UPetersen/LibreMonitor/GlucoseVsRawForDifferentTemperatures.png

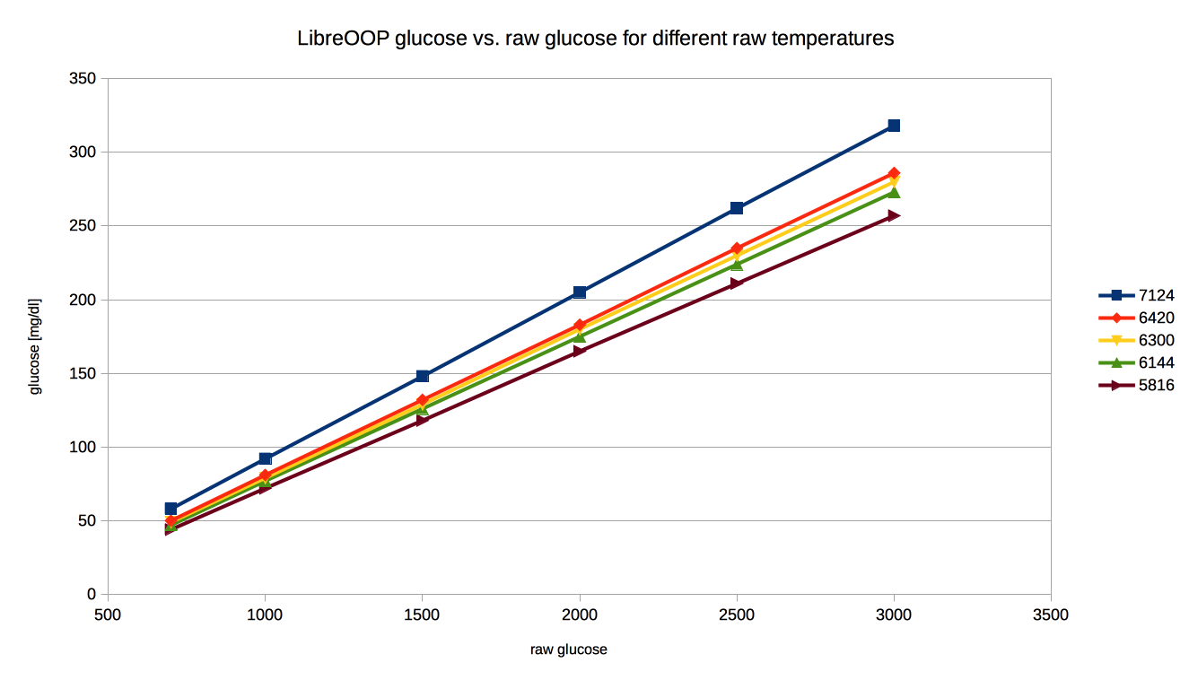
GlucoseVsRawForDifferentTemperatures.png
