UPetersen/LibreMonitor/GlucoseVsRawTemperatureForDifferentRawGlucoses.png

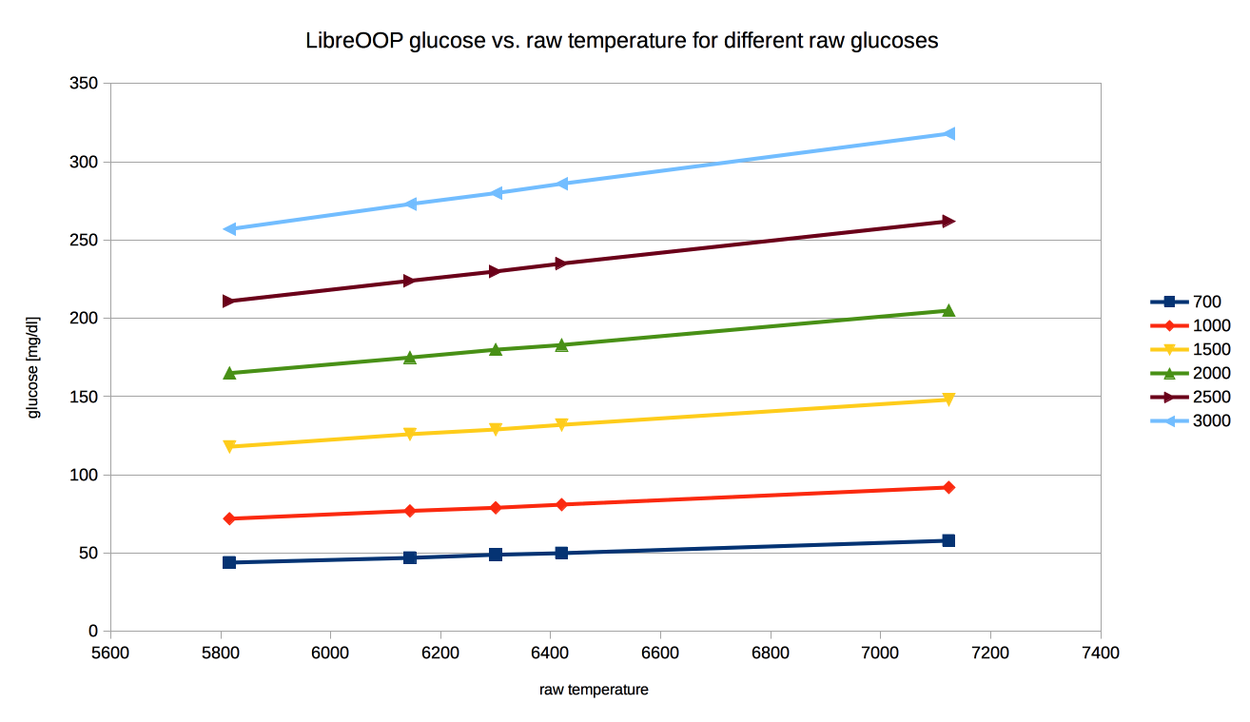
GlucoseVsRawTemperatureForDifferentRawGlucoses.png
