UPetersen/LibreMonitor/GlucoseVsRawTemperatureForRawGlucose700.png

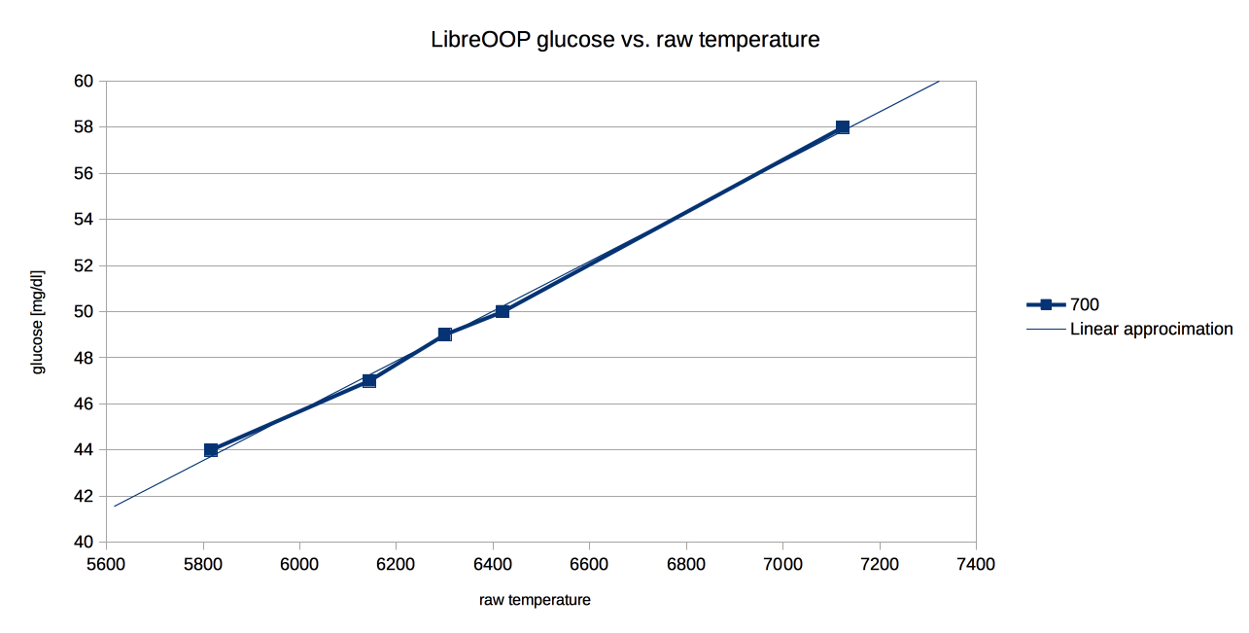
GlucoseVsRawTemperatureForRawGlucose700.png
