UPetersen/LibreMonitor/LinearResponseToRawGlucose.png

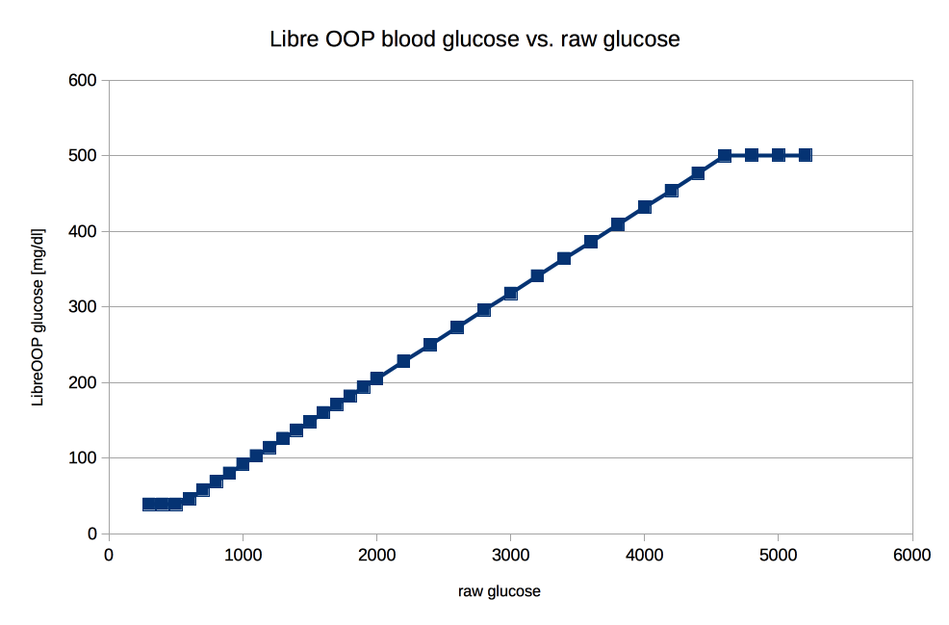
LinearResponseToRawGlucose.png
