UPetersen/LibreMonitor/SlopeAndOffsetVsRawTemperature.png

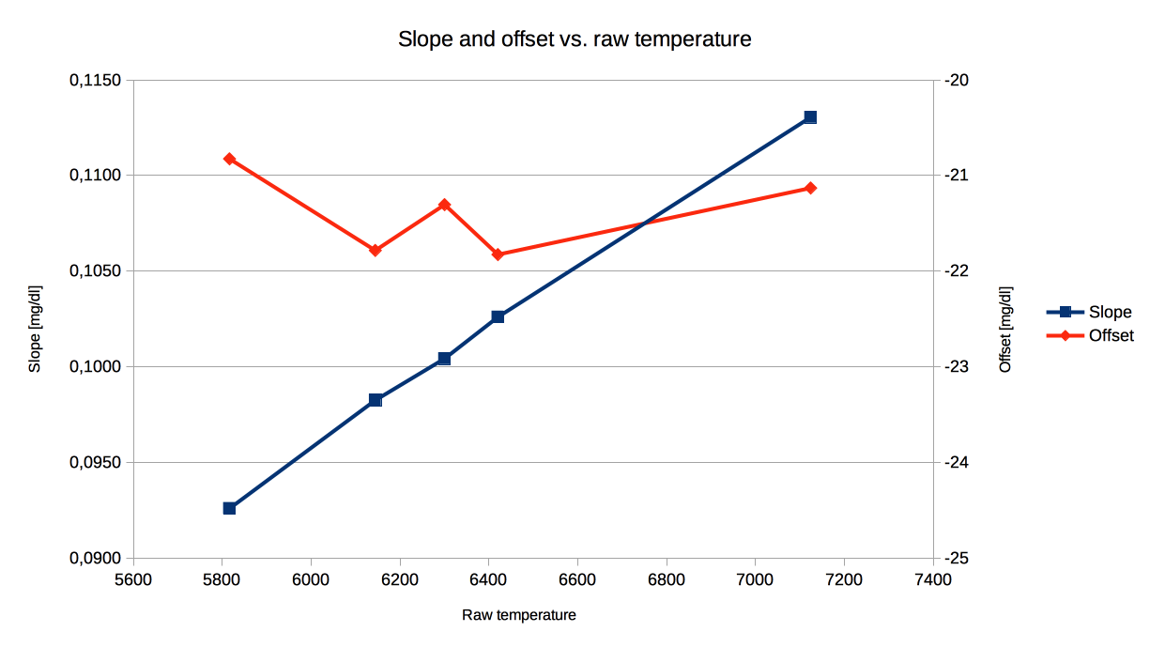
SlopeAndOffsetVsRawTemperature.png
