UPetersen/LibreMonitor/(threads)

Thread 2 (2016-11-23):

Sketchs from Arduino

hferreira, 2016-11-23:
Hello,

I built a limiter myself.

Some questions:
1. What are the differences between Simblee and RFDuino ?
2. The sketch from Limmiter will work on RFDuino without modifications, right ?

Regards,
Hugo.

UPetersen, 2016-11-23:
Hi Hugo,

My first LibreMonitor was built with an RFDuino and worked well. I then switched to a Simblee because it is smaller and also allows for FOTA (which I have not really used yet). So much for the differences (for more on this see the respective websites)

If you build a LibreMonitor with an RFDuino instead of a Simblee, you have to change some code in the LibreMonitor.ino file and in libUBP.cpp in LibreMonitorArduinoLibrary.zip. Basically you have to substitute „Simblee“ by „RFDuino“. I just looked quickly through the code. It should be the following two changes:

1. Use the appropriate includes for RFDuino instead of those fore Simblee
2. Change the Simblee commands to the respective RFDuino commands, e.g. change SimbleeBLE.advertisementData = "data" to RFDuinoBLE.advertisementData = "data"; etc.

Please refer to the manuals of [Simblee](https://www.simblee.com/Simblee%20Functions%20Reference%20V1.0.pdf) and [RFDuino](http://www.rfduino.com/wp-content/uploads/2014/03/rfduino.ble_.programming.reference.pdf) for details and possible differences of these commands.

If you do these code changes using #ifdefs in the code and submit a pull request I could check them in and it would be of help for others who want to build a LibreMonitor with an RFDuino, too. One could switch quite easily between Simblee or RFDuino by changing some #define commands and the includes in the info files.

Regards
Uwe

hferreira, 2016-11-23:
Ho, I thought that Simblee was a superset of RFDuino and larger than the original one, using the same chip on his core but I check and see that RFDuino is 15mmx15mm and Simblee is 7mmx10mm.

hferreira, 2016-11-23:
Hi Uwe,

Ho, I thought that Simblee was a superset of RFDuino and because of that was larger than the original one, using the same chip on his core but I checked and I saw that RFDuino is 15mmx15mm and Simblee is 7mmx10mm.
It's a superset yes but smaller, right ?
So, on this case it's more wise to use Simblee instead of the original RFDuino.

From the RFDuino website (so, the same should be applied for Simblee), the Arduino sketch should work of of the box for RFDuino, but you have some dependencies from Simblee, why ?
The original Limitter.ino can't work ?

Regards,
Hugo.

UPetersen, 2016-11-24:
Hi Hugo,

I am not sure, what you are aiming at and what you mean with "original Limitter.ino". Is it the Limitter.ino of the [LimiTTer Project](https://github.com/JoernL/LimiTTer) by JoernL? If so, the answer is no. The Limitter.ino will not work with LibreMonitor because LimiTTer and LibreMonitor transfer different sets of data between the reader device and the respective smart phone application.

If you want to use your device with LibreMonitor follow my suggestions above and you can display the data with the LibreMonitor iOS application.

If you want to build a LimiTTer and display the data with the corresponding application you have to make adaptions to its LimiTTer.ino to make it work with an RFDuino, but I cannot tell you what exactly has to be changed. You could try and ask this question on the respective [Gitter blog](https://gitter.im/JoernL/LimiTTer) and maybe get some help.

Regards,
Uwe

hferreira, 2016-11-24:
Hi Uwe,

I already have my own fork of the Limitter.ino working with my own Android App.
I thought that my ino sketch could work out of the box with RFDuino, because RFDuino is a kind of clone of Arduino + Bluetooth module but for what you are saying it's not just that easy, so I will have  review the code or start over again from your ino sketch.

The ideia behind using RFDuino (or Simblee) is to reduce the size and connections of the hardware.
By luck, seems that most of RFDuino/Simblee pins can be soldier next to BM019.

Regards,
Hugo.

UPetersen, 2016-11-25:
Hi Hugo,

wish you good luck.

Regards
Uwe

hferreira, 2016-11-25:
Thanks.

Closed 2016-11-25.

Thread 3 (2016-12-14):

Prepare the RFDuino/Simblee board

hferreira, 2016-12-14:
Hello,

After several weeks of delaying, I finally got my RFDuino  (similar to yours).
How did you safely remove the plastic from the pins to attach on the NFC board ?

Regards,
Hugo.

hferreira, 2016-12-14:
Nervermind. It was easy.

UPetersen, 2016-12-14:
Hi Hugo,
I have been working on a RFduino version, too. I just committed my current code for your ease. It is still work in progress and not yet tested, but probably a better starting point than the original code in this repository. (I seem to have a loose contact somewhere. So I could not receive valid data from the BM019, yet, but data transfer to the iOS app works.). You'll find some instructions in the comment section of the ino-File.
Regards
Uwe

hferreira, 2016-12-14:
Thank you very much.
It's a good starting point.

hferreira, 2017-01-09:
Hello,

I was out for a while and now I came back and return to this project.
Starting with your INO file and after compile and upload I got on my Arduino IDE debug window informing that the setup was successful (also my Android App can be notified about the connection) and it fails when to retried data from BM019 but this is probably the issue that you mention.

Regards,
Hugo.

basma37, 2019-05-03:
I have a compile error when trying to upload a code on rfduino

basma37, 2019-05-03:
Error is cannot run program(runtime.tools.arm-none-eabi-gcc.path)...

UPetersen, 2019-05-04:
This does not look like a LibreMonitor specific error to me, but rather like something general regarding rfduino. Have you managed to run any code on your rfduino so far?

Closed 2018-04-25.

Thread 4 (2016-12-18):

Light always fixed

hferreira, 2016-12-18:
Hello,

I already connected all wires on a breadboard (RFDuino + NFC-BM019).
I saw a lot of compile issues on your RFDuino ino version so I downloaded the original one and replaced all Simblee references to RFDuino. Compiled and uploaded to the hardware.

My Android App (that previous worked with Limitter, so the main difference should be the UUID address) is never notified but I also noticed that the NFC chip have the light always fixed.
On my previous version (based on Limitter), the light is off when is sleep mode and turn on when is reading.

PS: I already checked the wire connections over and over again.

Regards,
Hugo.

UPetersen, 2016-12-18:
Hi Hugo,

### Wiring

With the LibreMonitor wiring the red light on the BM019 will shine permanently. That is the intended setup using the on-board voltage regulator of the BM019. It is directly connected to the lipo and the 3.3 V output of the regulator serves as input to the RFduino.

### Ino-File and LimiTTer application

Using the LibreMonitor.ino file you will NOT be able to communicate with an app that expects data from a LimiTTer, as already noted in [issue2](https://github.com/UPetersen/LibreMonitor/issues/2). LibreMonitor and LimiTTer use similar hardware but are totally different on the software side since they use

- a different protocol to transfer data and
- a different set of data that is transferred between device and smartphone application.

Thus, the LibreMonitor.ino only works with the LibreMonitor iOS application. If you want to use a different application you have to either change the ino file accordingly to provide LimiTTer-like data or adjust your application to work with the LibreMonitor data set.

I am still not sure, If I correctly understand what your intention is. Do you want to make your Android application behave as the LibreMonitor iOS application and use the same protocol and data set? Or do you want to leave your app as it is and make the RFduino setup behave as a LimiTTer?

Regards
Uwe

hferreira, 2016-12-19:
Thank you for the explanation about the wiring.
OK, I see. It's always shinning (in opposite to Limitter) consuming a little more energy but not that much because only periodically BM019 is activated to read, so it's in a hibernate mode, correct ?

"Using the LibreMonitor.ino file you will NOT be able to communicate with an app that expects data from a LimiTTer"
Yes, I know. I have my own App and not xDrip. The base BT connection should be the same. Only the UUUID can be different and the chosen protocol that can be easily changed on INO or on my App.

I can now receive notifications on my App from the device trying to connect but still not fire the characteristics. I will investigate more.

Thank you very much for your time.

Regards,
Hugo.

UPetersen, 2016-12-19:
Correct, BM019 is periodically set to hibernate mode. After that the Simblee/RFduino is set to ultra low power mode (Simblee_ULPDelay(SLEEP_DURATION) /  RFduino_ULPDelay(SLEEP_DURATION) with SLEEP_DURATION set to two minutes). After the two minutes the Simblee/RFduino wakes up, wakes up the BM019, both do their job and then go to sleep again...

Note, using the Simlcee/RFDuino_ULPDelay(...)-command the Simblee/RFduino remains connected to the Smartphone application, but energy consumption is low. I like this mode since it can be conveniently used as a permanent indication for a working connection.

##### Data Transfer

I use [this ](https://github.com/cconway/RFduinoUBP) code to have a simple to use protocol. You can give it a c-struct with content longer than 20 bytes. The data is encapsulated using [SLIP](https://de.wikipedia.org/wiki/Serial_Line_Internet_Protocol) and a crc8 is appended to ensure data integrity. The packet is then transferred to the iOS application. There the crc8 is checked and if it is okay the packet is decoded back to the original struct. I made some changes to the [original code](https://github.com/cconway/RFduinoUBP) to make it work with the 344 bytes, so you may want to use the code from the LibreMonitor repository.

The c-structs are defined in [data_types.h](https://github.com/UPetersen/LibreMonitor/blob/master/LibreMonitor/Bluetooth/data_types.h). The main Freestyle Libre data that is transferred are the 344 bytes in "allBytes" of the struct "AllBytesDataType" that correspond to Blocks 0x00 to 0x2A when you read a sensor with [tagInfo](https://play.google.com/store/apps/details?id=com.nxp.taginfolite&hl=de) or some other tag reader. You can follow the code in [SensorData.swift](https://github.com/UPetersen/LibreMonitor/blob/master/LibreMonitor/Model/SensorData.swift) and corresponding files on how to get desired information such as history and trend raw glucose data.

##### Bluetooth

The main part of the bluetooth code on the application side is in [SimbleeManager.swift](https://github.com/UPetersen/LibreMonitor/blob/master/LibreMonitor/Bluetooth/SimbleeManager.swift). In there you find how I handle the UUIDs, services and characteristics. When a data packet is received it is then handled in [this](https://github.com/UPetersen/LibreMonitor/blob/master/LibreMonitor/ViewControllers/BloodSugarTableViewController.swift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) part of BloodSugarTableViewController.swift. This is where the c-structs are received as "payloads" and the data is extracted.

Hope this provides some help for your own application. It took me quite some time to understand the bluetooth stuff and build this application. Wish you good luck.

Of course you can use any other more simple protocol for data transfer.

Regards,
Uwe

Thread 5 (2016-12-21):

Parts needed for a LibreMonitor are - broken battery link

clvsjr9, 2016-12-21:
The lipo link indicated is broken

UPetersen, 2016-12-21:
I still use a 100 mAh lipo that I took out of a little model helicopter. It lasts a full day from early morning to late evening with the transfer interval set to two minutes. To my understanding any lipo with 110 mAh or more should do. If you want a longer time you could go higher, e.g. 200 mAh. A higher discharge rate is probably better and enables using a faster charger. I corrected the link in the readme for a lipo that should be appropriate.

Closed 2016-12-21.

Thread 6 (2016-12-21):

Switch lipo charger example

clvsjr9, 2016-12-21:
Could you indicate a switch lipo charger URL to appreciate?

UPetersen, 2016-12-21:
I only have experience with the first of the two Adafruit lipo chargers that are mentioned in the readme and the "SparkFun LiPo Charger Basic", which worked fine, too. I have no experience with any other lipo and thus cannot recommend any other.

clvsjr9, 2016-12-21:
The readme file presents the follow text:

Switch (optional but helpfull if you mount a lipo charger).

Could you point to me any product to this item? (I'd like to use one)

UPetersen, 2016-12-22:
A switch is helpful to disconnect the BM019 and Simblee/RFDuino from power, if the device needs a reset. LibxMike used a setup with a switch, as you can see in the picture in the readme. I haven't used a switch by myself, yet, and that is why I did not provide a link and cannot really recommend one from own experience. I always disconnect and reconnect the JST plug of the lipo if a reset is needed. I made a quick search and think the following [switch](http://www.exp-tech.de/mini-slide-switch-3-pin-spdt-0-3a-3-pack) should be okay and serve your needs.

clvsjr9, 2016-12-24:
Very thanks!

Closed 2016-12-24.

Thread 7 (2017-01-10):

Thank you

hferreira, 2017-01-10:
I created this issue only to thank you UPeterson.

My current INO file it's very different but finally working now !
Your layout helped me go to there.
I had to remap the original pins: http://www.rfdigital.com/wp-content/uploads/2014/03/rfduino.ble_.programming.reference.pdf and probably it's one difference comparing to Simblee.
I wanted the pins on the same configuration as yours because fits perfectly on BM019.

Best regards,
Hugo.

UPetersen, 2017-01-10:
Hi Hugo,

great to hear, that you got your device working. Congrats.

Regarding the remapping I actually put some information in the [LibreMonitor.ino](https://github.com/UPetersen/LibreMonitor/blob/master/LibreMonitor.ino#L26) as guidance on how to modify the variant.h file and a note on this in the [README.md](https://github.com/UPetersen/LibreMonitor/blob/master/README.md). But thanks to your remarks I will make this more prominent in the future.

Just out of curiosity: What kind of smart phone app do you use? Is it based on LibreMonitor or did you develop it yourself or?

Best regards,
Uwe

hferreira, 2017-01-10:
Hi Uwe,

Thank you.

Yes, the remapping was missing for me and it's a key feature for this project because allows to connect to NFC directly and reduce wires.

My own App: https://play.google.com/store/apps/details?id=pt.solidsoft.appforlibre
This App allows to read directly from NFC (like others) and I changed enough to also read from BLE reusing the same Widget and chart.

Best regards,
Hugo.

Thread 8 (2017-01-16):

Battery test

hferreira, 2017-01-16:
Hello,

I made 2 tests with a full charged batteries:
- LiPo 3.7v 240mAh - After 24h with 3 m sync period consumed only 35%.
- LiPo 3.7v 120mAh - After 18h with 5 m sync period consumed 90% and the system sttoped to communicate.

Do you think this is a normal behaviour ?

Regards,
Hugo.-

UPetersen, 2017-01-16:
Hi Hugo,

I have been using a 150 mAh lipo for a long time. I put the libreMonitor on ever morning and take it off when I go to bed (because I don't want to lie on it and possibly brake it, since I still don't use a case) and then I charge it over night. With a reading every two minutes even on long days with up to 18 or 20 hours it still worked when I took it of. And this even though the Simblee keeps a permanent bluetooth connection to the iPhone between the readings (with "Simblee_ULPDelay" command).

I put your and my values in the following table. Unfortunately I don't have a means to measure the remaining capacity for my lipo so I just assumed 100 percent.

|        | Hugo 1 (RFduino)| Hugo 2 (RFduino) | Uwe (Simblee) |
| :--- | :---:  |     :---:      | :---: |
|lipo energy [mAh] | 240 | 120 | 150 |
|used energy [%] | 35 | 90 | 100 |
|used energy [mAh] | 84 | 108 | 150 |
|usage time [h] | 24 | 18 | 18 |
|delay between readings (min) | 3 | 5 | 2 |
|reading frequency [1/h] | 20 | 12 | 30 |
|number of readings in usage time | 480 | 216 | 540 |
|energy consumption per reading [mAh] | 0,175 | 0,5 | 0,28 |

So your large lipo performs very well in comparison to mine but your smaller lipo could do better. Overall it looks reasonable to me. Since I don't know what changes you possibly made: Please note that this comparison is only valid on the assumption that you read and transfer the same amount of data.

Regards,

Uwe

hferreira, 2017-01-16:
Hi Uwe,

Thank you very much for your comparison table.
I will also test for 2 minutes.
Do you find that there is any side effect with 1 minute besides the battery faster consume.

Yes I used always the same sample data to avoid mistaken results.
I agree that my large lipo performs very well (more that what was expected), however my smaller lipo is not enough (I wanted 24h / one day charge) for the same 3 minutes (at most).
Shouldn't the smaller lipo performance as 50% comparing to the bigger one ?
I mean, for he same 24h (3 minutes delay), consume 70% energy ?

Regards,
Hugo.

UPetersen, 2017-01-17:
Hi Hugo,

I never tried a one minute interval. I just don't think it is necessary. I like the two minutes pretty much. Three minutes seems reasonable, too, but five minutes is just to long for me.

I am not sure if the one minute interval will have side effects.

Regarding side effects: Rarely, but it sometimes happens that I don't get a response from LibreMonitor any more and the Freestyle Libre Reader also refuses to provide values. Usually, after a while everything works fine again. And usually I take the LibreMonitor of when this happens. I do not know why this happens and I don't know if this is caused by LibreMonitor at all. But for sure I know that I had observed this with sensors before having started to use LibreMonitor, too. Same with sensors that completely failed. Just got two such cases recently with sensors that were very close to their expiry date. But also did have this in the early days without LibreMonitor.

To sum up: If you are keen on a one minute interval you have to try yourself. I personally would not expect problems, but who knows. And yes, I'd be interested in the results.

Lipo: Yes, I would have expected the small lipo to perform more equally, too. Maybe it has a different discharge capability (if this is of influence) and it could also be just a bad lipo. I guess that to be really sure about lipo performance and requirements more systematic tests will be necessary.

Regard
Uwe

hferreira, 2017-01-18:
Hi Uwe,

"I never tried a one minute interval. I just don't think it is necessary. I like the two minutes pretty much. Three minutes seems reasonable, too, but five minutes is just to long for me."
I agree with you.

"I am not sure if the one minute interval will have side effects."
Stop working for example but I will use 2 or 3 minutes.

"Regarding side effects: Rarely, but it sometimes happens ... "
I'm doing tests and experience exactly the same behaviour (I see that I'm not alone here :))

"Lipo: Yes, I would have expected the small lipo to perform more equally, too. Maybe it has a different discharge capability (if this is of influence) and it could also be just a bad lipo. I guess that to be really sure about lipo performance and requirements more systematic tests will be necessary."
I have been reading about discharge capability and in theory yes, it can influence a little but I don't believe that much. I bet in got bad 120mAh Lipo and a very good 240mAh one.
I'm expecting to receive tomorrow a new 150mAh (with the same discharge capability as the 240mAh and let's see how performe this one).

Regards,
Hugo.

hferreira, 2017-01-19:
A new test with a new LiPo 150mAh.
After 24h with 3m interval it keep working with full charge (of course it's not possible and a read battery level issue) but working.

A will run a new 24h test with the same 150mAh LiPo but now with 2m interval.

kozyretti, 2017-12-28:
What about safety of LiPo using?
The device is fixed on the arm all the time. Is this not dangerous?
I mean a sudden ignition.

UPetersen, 2017-12-28:
I do use a regulated Lipo and I haven't had any bad experience so far. Neither have I heard of any bad experience from similar projects like [LimiTTer](https://github.com/JoernL/LimiTTer).

Thread 9 (2017-03-09):

A series of build errors

erikstr, 2017-03-09:
I am trying to build the iOS app straight out of the fresh downloaded sources, but getting a lot of errors. Here is a screenshot of them. What am I doing wrong?
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

UPetersen, 2017-03-09:
Hi Erik,

have you installed cocoapods? There are some third party libraries used, that require cocoapods. For installation [https://cocoapods.org](https://cocoapods.org).

erikstr, 2017-03-09:
No, I hadn't :( sorry that I didn't pay attention to this.
However, even with the Charts lib installed, I still get compile errors :((
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

erikstr, 2017-03-09:
Here are the full details:
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

UPetersen, 2017-03-09:
Mmmh, that leaves me scratching my head. I just downloaded the code from GitHub myself, ran "pod install" in the directory, opened the workspace file and compiled with simulator vor iPhone SE and it runs. I use Xcode 8.2.1.
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

UPetersen, 2017-03-09:
Have you tried to clean the build (Product and then "alt" - "Clean Build Folder". Sometimes that helps.

UPetersen, 2017-03-09:
Also worth a try (last answer): [swiftc failed with exit code 1](http://stackoverflow.com/questions/41203153/swiftc-failed-with-exit-code-1).

UPetersen, 2017-03-09:
Or this one: [ERROR swiftc failed with exit code 1](http://stackoverflow.com/questions/38496582/error-swiftc-failed-with-exit-code-1).

erikstr, 2017-03-09:
8.2.1 here as well. Yes, I clean every time. I suspect, that I am doing something wrong with the Charts lib. The instruction there says "Drag the Charts.xcodeproj to your project". However you can't drag just this file leaving the whole folder structure behind, so I download the zip, unpack it and include the lib from there to the target.

erikstr, 2017-03-09:
I'll switch to my MacBook now and start over from scratch ...

UPetersen, 2017-03-09:
I never dragged the charts lib. I installed it via cocoapods. Try this: Once you have cocoapods installed, just download the complete LibreMonitor-project again. Open a shell, change into the LibreMonitor directory and there type "pod install". Then open the workspace file with Xcode and compile.

erikstr, 2017-03-09:
Success!
It turns out that the downloaded charts lib I previously linked is for macOS only, no iOS. Now the app compiles and runs on the iPhone. The RFduino connects also fine but I am getting no readings :( What worries me even more is that no BM019 ID is shown as when there is no connection between the RFduino and the BM019 module. The ino sketch compiled and loaded fine. How could I investigate this problem now? I checked the wiring, looks good. But the BM019 LED is lighting red. Is this normal?

erikstr, 2017-03-09:
Here is a screenshot:
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

UPetersen, 2017-03-10:
This looks good. The right light on the BM019 is right. And you have a bluetooth connection to the RFduino. Now you should check, wether you get valid signals on the Arduino side, best by using the serial monitor. Set the

`#define DEBUG `

and you should see some hex values. To reduce your waiting times, you can reduce the sleep time for tests, e.g. by setting it to 20 s:

`const uint64_t SLEEP_DURATION = 20000;  // Duration of Simblee ultra low power mode in ms`

Another important thing is to have the SPI wiring correct. If you wired as depicted in the pictures, you have to change the RFduino pins in software. This is done in the variant.h file. In my case this file is located (dependent on the Simblee/RFduino version) in

/Users/[my user name]/Library/Arduino15/packages/Simblee/hardware/Simblee/1.0.0/variants/Simblee or
/Users/[my user name]/Library/Arduino15/packages/RFduino/hardware/RFduino/2.3.3/variants

In this file set the defines for the SPI pins as follows:

```
///         #define PIN_SPI_SS           (3u)
///         #define PIN_SPI_MOSI         (5u)
///         #define PIN_SPI_MISO         (4u)
///         #define PIN_SPI_SCK          (6u)
```

I also sent you a private note on gitter.

Thread 10 (2017-09-27):

Translation for raspberry

F5OEO, 2017-09-27:
Thx for your amazing work. I am working on a raspberry pi version, your code is my basis to communicate with FreeStyle. I wonder if you have links for more details about the protocol. Glimp (closed source) can indicate for example if sensor is outdated...

My goal is to send datas directly to nightscout (not yet enough info to do that).

UPetersen, 2017-09-27:
The information if a sensor is expired resides in byte #4 of the header, see [SensorData.swift](https://github.com/UPetersen/LibreMonitor/blob/swift3.2_xcode9/LibreMonitor/Model/SensorData.swift#L47).

All what I know about how the Freestyle Libre data can be interpreted is actually represented in the [SensorData class](https://github.com/UPetersen/LibreMonitor/blob/swift3.2_xcode9/LibreMonitor/Model/SensorData.swift#L1) and the other classes in the [model directory](https://github.com/UPetersen/LibreMonitor/tree/swift3.2_xcode9/LibreMonitor/Model). I do not know about any complete and good documentation, other than Pierre Vandevenne's [Blog](http://type1tennis.blogspot.de). (Start Reading somewhere in late 2014.)

Regarding nightscout: I implemented a nightscout upload in the swift3.2_xcode9 branch, using code from [NightscoutUploadKit](https://github.com/ps2/rileylink_ios/tree/master/NightscoutUploadKit). The relevant code portions are located in the [NightscoutUploader](https://github.com/UPetersen/LibreMonitor/tree/swift3.2_xcode9/LibreMonitor/NightscoutUploader) directory. I call it [around here](https://github.com/UPetersen/LibreMonitor/blob/swift3.2_xcode9/LibreMonitor/ViewControllers/BloodSugarTableViewController.swift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) to upload all history data. It works quite well. This branch also has a [settings view](https://github.com/UPetersen/LibreMonitor/blob/swift3.2_xcode9/LibreMonitor/ViewControllers/SettingsViewController.swift) to enter nightscout site and API secret.

F5OEO, 2017-09-27:
Greatly thx to all these links...you save hours of googling and github search ! As I am an old style guy, I have surely to translate to C but ressources is there ! Again a great thx to your contribution. Hope to publish something working (but ugly as my usual style). Let me know if I can send you detail question out of an "issue github scope" directly by mail. evaristec @ gmail dot com

Thread 11 (2018-04-25):

Can't find "Charts" module

JJBarata, 2018-04-25:
Hi! I downloaded the latest files and followed all their guidelines, however, when trying to build the application, I'm getting some warnings and a strange error that refers to importing the module "Charts", which it does not find. Here are the screenshots. What am I doing wrong? Tks.

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

JJBarata, 2018-04-26:
Thanks for reply!

I used master branch on swift 4 and xcode 9.3 environment. I did all steps that you suggested (installed cocoapods, ran "pod install" on project folder, opened "LibreMonitor.xcworkspace", cleaned build folder, added "Charts.framework" on Embedded Binaries and tested on iPhone SE) but when I test, appear all issues. I did it right?

I using Simblee hardware with BM019 module.

I will test with 25 Nov. 2017 branch and I will post here the results.

Thank you very much and congratulations for your awesome project!!

JJBarata, 2018-04-26:
Well, I ran now and return one error, at least! I noticed that all errors occur because of the Charts. I made some changes on Pods and Charts build settings like prints bellow.

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

Thanks!!

JJBarata, 2018-04-26:
I made it work. I ran on my iPhone 7 Plus. I installed Charts with Carthage, as you indicated. Now I will configure the Simblee and the BM019 to be able to scan the FL.

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

Thank you very much!!

UPetersen, 2018-04-26:
😄

Closed 2018-04-26.

Thread 12 (2018-05-07):

App no show glucose level and others informations

JJBarata, 2018-05-07:
Hi Uwe,

As I said before, I was able to run the app from the version you indicated, but I can not get the app to show the blood glucose level, blocks, status and start of the sensor, and the graph with the measurements. I see in the Arduino IDE that the BM019 reads the sensor and sends, via Simblee, the packets and information so much that I can see the ID of the BM019, the sensor ID and the ambient temperature and voltage, as in the image below. I'm not using lipo, I'm using the USB cable on the Mac.

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

I did the tests with some sensors, already expired and with an active sensor that my son is using.

If you need more information, just talk.

I'm grateful for your help.

Thank you,

Jorge

UPetersen, 2018-05-08:
Hi Jorge,

so the data transfer between simblee and iOS works, and the BM019 is connected to the simblee, since its ID is transferred, too. This is already quite good. Now the question is why you do not receive any data from the sensor. Having the simblee attached to USB while running is okay, I did so often, too. As a next step I suggest you try to print out some data with the serial monitor of the Arduino IDE (if this what you use as IDE) and submit it here. You should uncomment the

`
 #define DEBUG
`

to receive the information from all the print commands in the code. Could you also give me a link to the arduino code you are using?

UPetersen, 2018-05-09:
Mmh. Data in serial monitor looks good. FRAM data is read properly. So the question is, why this data does not arrive in the app. Next step would be to set a stop point in the debugger in [here](https://github.com/UPetersen/LibreMonitor/blob/485aed2ed195b788dd1d83d54b68caf70610adc5/LibreMonitor/ViewControllers/BloodSugarTableViewController.swift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) and see what cases are run through. This is the code section where the different data types are received. According to the screenshot you provided above,

`case .SYSTEM_INFORMATION_DATA:`

works and

`case .BATTERY_DATA:`

works, although the battery value should be higher, and

`case .IDN_DATA:`

also works. The question is, why

`case .ALL_BYTES: `

seems not to work. Please run the debugger and check weather the `case .ALL_BYTES: ` code section is called or not. (If not, we have to double check the data types: files data_types.h and constants.h must be the same in the arduino code and the app code.) To get the os_log outputs in the debugger, you have to comment out the lines after [here](https://github.com/UPetersen/LibreMonitor/blob/485aed2ed195b788dd1d83d54b68caf70610adc5/LibreMonitor/AppDelegate.swift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). We'll then continue.

JJBarata, 2018-05-10:
I agree!

The code in the constants.h and data_types.h files are the same in Arduino and in the application.

I made debbug and the output log and prints are in the folder I shared earlier.

I noticed that many of the data could not be read, as I show in the prints.

If you need more information, I am at your disposal.

Thank you!

UPetersen, 2018-05-10:
The prints look good to me. It is the case of system information data received and all is going well. The question is, why the case with the fram data (allBytes) is not called. Could you set a break point behind

`case .ALL_BYTES:`

to see if it gets ever called? If this is not the case I recommend we continue this by phone. Sent you a PM on gitter.

Thread 18 (2019-03-21):

Just a question

JMCPH, 2019-03-21:
Hi!

I'm a IT student at the IT-university of Copenhagen. I'm about to write my master thesis about diabetes and how technology can support parents with children diagnosed with diabetes.

I have a question regarding the code which scans the NFC tag from the Freestyle Libre Sensor.

I can't seem to find the files for the Arduino, where the actual scanning and processing of the NFC dataset from the sensor to the Arduino is done.

The goal is to develop an iOS application, which can scan the NFC tag directly from the Freestyle Libre Sensor, instead of sending it over bluetooth.

Best Regards,

Jakob

UPetersen, 2019-03-22:
Hi Jakob,
the original Arduino code is in the most top directory of this repository: [https://github.com/UPetersen/LibreMonitor](https://github.com/UPetersen/LibreMonitor.)

I switched to plattformio some time ago and then put the code into a separate repository: [https://github.com/UPetersen/LibreMonitorRFduino](https://github.com/UPetersen/LibreMonitorRFduino). So this is the best starting point.
If you plan to scan directly, it should be sufficient to read the first 43 blocks of FRAM data and the tag ID.

Please use the [swift4](https://github.com/UPetersen/LibreMonitor/tree/Swift4) branch for any iOS coding as it contains the most current code.

All the best,

Uwe

Closed 2019-05-01.

Thread 19 (2019-04-30):

Comments regarding Libre OOP Investigation

JtxGit, 2019-04-30:
Trying to understand how things work has always fascinated me and I found your "Libre OOP Investigation" very interesting.

You said:

>

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

In this case we can use a bi-linear function (as is, for example, used in linear finite element formulations):
z = a1 + a2 x + a3 y + a4 xy

These 4 constants can (relatively easily) be found if we have 4 known values of z for given x and y.
This might give us a smaller target to aim for in trying to find some clues in the header / footer.

From your investigation, it is clear that each sensor will have different values for these a1 to a4.
Perhaps we can find promising candidates in the header or footer.

Just for the record, the "traditional" "slope" and "offset" can be calculated for each raw temperature as follows:
offset[T] = a1 + a3(T)
slope[T] = a2 + a4(T)

Regards
jtx

UPetersen, 2019-05-01:
Hi Jtx,

you exactly got the point. Further down in the wiki I elaborate also on this, except that I do not use a1 to a4 but rather these terms:

&nbsp;&nbsp;&nbsp;&nbsp;&nbsp;&nbsp; **glucose = slope(raw_temperature) * raw_glucose + offset(raw_temperature)**

where slope(raw_temperature) and offset(raw_temperature) are derived from the two equations

&nbsp;&nbsp;&nbsp;&nbsp;&nbsp;&nbsp; **slope(raw_temperature) = slope<sub>slope</sub> * raw_temperature + offset<sub>slope</sub>**

&nbsp;&nbsp;&nbsp;&nbsp;&nbsp;&nbsp; **offset(raw_temperature) = slope<sub>offset</sub> * raw_temperature + offset<sub>offset</sub>**.

The four parameters slope<sub>slope</sub>, offset<sub>slope</sub>, slope<sub>offset</sub> and offset<sub>offset</sub> are sensor specific and thus have to be derived for each sensor at the beginning of its lifetime. I use the [SwiftLibreOOPWeb](https://github.com/dabear/SwiftLibreOOPWeb) web interface for deriving these parameters.

All this is implemented in the swift4 branch of LibreMonitor and works pretty well.

Regards
Uwe

JtxGit, 2019-05-08:
To experiment some more, I created a simple Android app that allows me to enter (or read from a file) the header and footer. It then can calculate 4 points (T 5816 and 7124, G 1000 and 3000 as your example), using the OOPAlorithm apk. From these it calculates a0 to a4. Now to try and recognise a pattern...
Unfortunately my available data is only from 2 sensors, so not really enough. Now, I'm wondering if there perhaps is a list of known headers and footers somewhere that could be used to create a bigger data pool to use for pattern recognition.

UPetersen, 2019-05-09:
There is no common list of headers and footers to my knowledge. But I have plenty from my own sensors, that I can provide you with. If you give me your mail address or a private message on gitter, I can sent you some data.

JtxGit, 2019-05-09:
I'm not sure how spam-sensitive leaving an email address is, so the best is to send it to android7@eko3-tek.se

(Remove all the numbers to get the real address)

Thanks in advance.

UPetersen, 2019-05-09:
Got the email and thus deleted it from your post.

JtxGit, 2019-05-09:
Thanks!

dabear, 2019-05-10:
https://libreoopweb.azurewebsites.net/Home/CalibrateSensor will give you the same parameters as output. Example implementation of those parameters into a function to calculate glucose:
https://github.com/dabear/pyderivedalgo/blob/master/pyderivedalgo.py

I see you have created your own app implementing a bi-linear function. Please note that you need static input for that to work. Readouts from the libre sensor will contain historic values and trend values. Abbott uses some form of extrapolation on top of this to yield a "currentbg". My calibratesensor endpoint removes extrapolation from their algorithm.

I have both swift and c# implementation of this available.

JtxGit, 2019-05-10:
Thanks for the information, I appreciate it and will have a closer look.

Before I got the LibreOopAlgorithm running on Android, I actually tried to use your CalibrateSensor page, but was unsuccessful, since I could not figure out what was required for "Accesstoken"...
Anyway, now that I have the LibreOopAlorithm running, I can easily "calibrate" a set of header / and footer by calculating 4 points (A, B, C, D) for 2 RawG and 2 RawT. Then I calculate the bi-linear coefficients a1 to a4 as follows:

`
    private static double G1 = 1000;
    private static double G2 = 3000;

    private static double T1 = 5816;
    private static double T2 = 7124;

    private static double dT = (T2-T1);
    private static double dG = (G2-G1);
    private static double a4 = (A+C-B-D)/(dG*dT);
    private static double a3 = ((D-A)/dT-G1*a4);
    private static double a2 = ((B-A)/dG-T1*a4);
    private static double a1 = A-G1*a2-T1*a3-G1*T1*a4;
`

With the bi-linear function, I can then calculate the historic and trend values from the raw values.
They correspond quite well with what the LibreOopAlgorithm gives for the same input.

The fun challenge is to see if one could find some correlation between header/footer data and these "calibrated constants" for each sensor.

soad89, 2020-08-30:
Hi Guys.

I would like to play with OOP header/footer dependency. Can someone guide me how to get running my own OOP with a possiblity to send there data over TCP/HTTP? Is physical device still the only solution?

In addition I would like to ask something which is still unclear for me even after studing gitter related threads:
1) Is Libre 2 over NFC encrypted or not and can be explained like L1 data.
2) Does anyone tried to massively forward artifial data to OOP and have some outputs of it?
3) Is not yet clear which bytes of header/footer are the ones that changes the output?

Thanks

UPetersen, 2020-08-31:
HI soad89,
regarding running oop own your own: please ask in the [gitter channel on oop](https://gitter.im/LibreOOPAlgorithm/Lobby) or ask @dabear for access to his web interface. You could also try [this](https://glucose.space), but I am not sure if this is the right link and how it is to be used.
To your other questions:
1. -> Libre2 over NFC is encrypted.
2. -> Not to my knowledge.
3. -> Yes, at least not to my knowledge. I have fiddled around a bit myself varying header and footer bytes and observing if they change the glucose results. And it seemed to me that many of those bytes do have an influence on glucose results. But I could not determine any rule or algorithm behind this.

soad89, 2020-09-01:
Hi UPetersen,

What is a then current status of Libre2 handling? Has anyone broken the encryption so one can use Libre1 formula? Or is oop only way how to get glucose? I supose that you can pass encrypted data to oop for L2, right?

Thank you very much for your answers.

JtxGit, 2020-09-01:
I also played with the headers and footers. Unfortunately no "A-ha" moments...
Then I got oopalgorithm running on my phone, which moved playing with the raw data down on my to-do list.

As for L2 decryption, the LibreTools (by ivalkou) repository (for IOS) looks very interesting. I'm running android, so I have not looked into it in detail.

Closed 2019-09-29.

Thread 22 (2020-09-15):

Is this portable to Swift?

peter-docpack-co, 2020-09-15:
Not so much of an issue as a question. Our project is looking to use the same algorithm in an iOS application. is there any reason it could not be ported to Swift? Also, in case the owner of this repo is available for such work, please hit up peter a-t viv d-o-t co, thanks!

UPetersen, 2020-09-15:
This project is already an iOS application written in swift.

Closed 2020-09-15.

Thread 23 (2021-01-08):

Trend value index seems to be not in Range

deepakthakur143, 2021-01-08:
In SensorData.swift file
` let headerRange =   0..<24   //  24 bytes, i.e.  3 blocks a 8 bytes`
  `let bodyRange   =  24..<320  // 296 bytes, i.e. 37 blocks a 8 bytes`
 ` let footerRange = 320..<344  //  24 bytes, i.e.  3 blocks a 8 bytes`

  `self.nextTrendBlock = Int(body[2])`

 ` for blockIndex in 0...15 {.                            //The trendMeasurement function logic is`
   `         var index = 4 + (nextTrendBlock - 1 - blockIndex) * 6 // runs backwards`
  `          let range = index..<index+6`
  `          let measurementBytes = Array(body[range])`
  `          .......`

Following is the byte array read through NFC from the Libre Sensor
-86 45 0 0 3 0 0 0 0 0 0 0 0 0 0 0 0 0 0 0 0 0 0 0 74 70 **71** 89 48 56 50 45 84 48 56 56 52 63 -36 73 102 -125 16 0 105 10 -64 78 20 3 -106 -128 90 0 -19 -90 26 127 90 -22 4 -27 -118 104 -46 2 -56 27 0 0 0 0 -70 40 -85 16 11 0 28 1 -35 67 -22 -60 -103 2 -44 67 -22 -40 90 2 -60 67 -22 -20 90 2 -59 67 -22 -64 -102 2 -66 67 -22 -24 27 2 -70 67 -22 -28 90 2 -75 67 -22 20 91 2 -75 67 -22 32 91 2 -82 67 -22 56 91 2 -80 67 -22 24 91 2 -87 67 -22 -8 -102 2 -26 67 -22 -52 27 2 -52 67 .......and more bytes

Note: Bold ones is at 26th position, i.e, body[2], (24 bytes for header & 2nd byte in body)

`self.nextTrendBlock = Int(body[2])`                                 =>  since body[2] = 71, therefore nextTrendBlock = 71.
 `var index = 4 + (nextTrendBlock - 1 - blockIndex) * 6 ` => index = 4 + (71 - 1 - 0) * 6 = 424

Here, the index comes to be 424, but the bodySize is expected to be 296 bytes, i.e., out of index.

So I am concerned here if
a) The byte layout has changed since this code was first written.
b) Was this code developed for a fixed byte layout format.

PS: I used NFC to pull out data from the LibrePro sensor.

UPetersen, 2021-01-08:
The code ist tested for Libre1. LibrePro has a different Layout. Please search the web for information about LibrePro-Layout. Doing a quick search I found [this](https://github.com/JoernL/LimiTTer/issues/29). Thus, Libre Pro seems to have more history records than the Libre 1.

Regarding the numbers: you have negative integer values, which should not be the case. The range of the numbers should be between 0 and 255. Thus, please convert the bytes to Uint8.

deepakthakur143, 2021-01-08:
Thank you so much @UPetersen . This link would sure be helpful for me. I have been working on this for a month now, but without much success. I will explore further.

UPetersen, 2021-01-08:
No worries. Meanwhile there are quite a few other projects, that are also more up to date than LibreMonitor, some of which might also address the Libre Pro. A good starting point could be to get through the list of my starred projects and have a look at those that are a) on the libre and b) where recently updated.

UPetersen, 2021-01-09:
Closed.

Closed 2021-01-09.

Thread 24 (2023-04-17):

Quick Question

balasuper, 2023-04-17:
This is regarding reuse  the sensor but with another ADC device . Since the clever bits of libre are the pt-ir skin sensor , and the current measurement pads are exposed ,is it possible to read them using another current measurement op amp and ADC?

Since the sensor just wears out when the reagents are used up (and it seems to be software locked to 14 days) would interfacing directly with the sensor be a viable way to extend the life of sensor?

My embodiment of this idea is to use a  hacked /normal finger prick  meter to actually measure the sensor still stuck to the skin.

Sure its not a flash CGM  but its 90% there. Apologies in advance if not correct forum.

UPetersen, 2023-04-19:
Dear balasuper,
I personally would refrain from any such efforts. There is software available to read the sensor and some of which extend sensor life by 12 hours, see e.g. [Juggluco](www.jugluco.com) which is open source. I have not heard of anyone going beyond 12 hours.

Closed 2023-04-19.
