UPetersen/LibreMonitor/(commit log)

2016-10-22 Switched to english text and minor changes to the blood sugar graph (automatically zoom to appropriate ranges)
2016-10-23 Added Arduino library zip file
2016-12-14 Add files via upload
    Uploaded draft versions of arduino code that should work with an RFduino. Not yet tested.
2016-12-21 Update README.md
    Corrected link to lipo on exp-tech.de.
