UPetersen/LibreMonitor/(notices)

Notices in the files:
LibreMonitorRFduino.ino:
Copyright (c) 2015 Uwe Petersen, all right reserved
https://github.com/cconway/RFduinoUBP under the following license:
The MIT License (MIT)
Copyright (c) 2015 cconway
